lidal/Redtooth/batteryPackCover/MainBody-Body.3mf

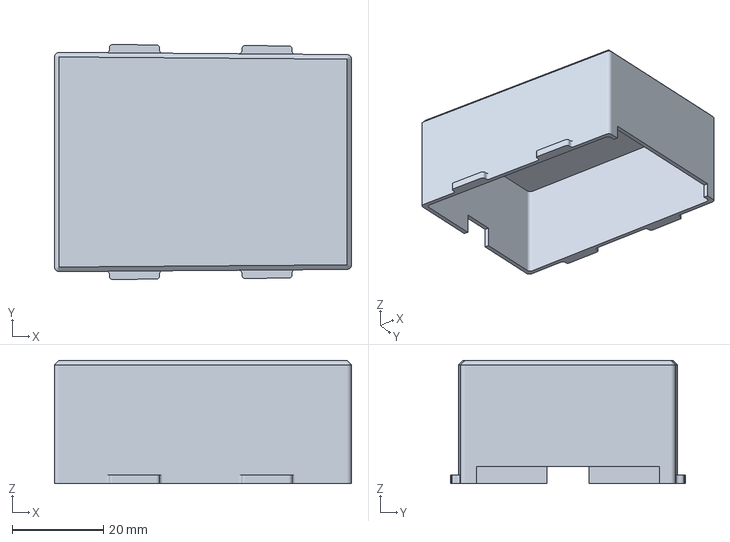
[picture p4: CAD file, 2026-10-31]
batteryPackCover/MainBody-Body.3mf
65.0 x 51.4 x 27.0 mm
