lidal/Redtooth/(list of files, cad)

Other CAD files:
batteryPackCover/MainBody.FCStd
