lidal/Redtooth/(commit log)

2026-10-31 Virtual Boy Bluetooth controller: ESP-IDF firmware and battery case
    Firmware for an ESP32-C6 Feather with three modes (Android gamepad, Xbox
    controller for the 8BitDo adapter, Switch 2 Pro Controller), the FreeCAD
    battery case, and photos of the finished controller.
    [MainBody-Body.3mf, MainBody.FCStd, partitions.csv]
2026-10-31 Rename to Redtooth and add a wiring schematic
    The schematic is drawn with schemdraw from docs/wiring.py, using the
    original controller cable's wire colours.
2026-10-31 Draw the wiring on Adafruit's Feather ESP32-C6 drawing
    docs/wiring.py now builds the SVG itself around the breadboard view of
    Adafruit's Fritzing part (CC BY-SA 3.0) and routes each cable colour to
    its header pin. The README explains the red power-switch wire and IO7.
2026-10-31 README: explain that the red wire is cut and wired from the switch
2026-10-31 Move the battery case files from batteryPack/custom to batteryPack
    [MainBody-Body.3mf, MainBody.FCStd]
2026-10-31 README: add a section about the battery pack cover
2026-10-31 README: make the cover section "Mounting and battery pack cover"
