lidal/Redtooth/IMG_0148.jpeg

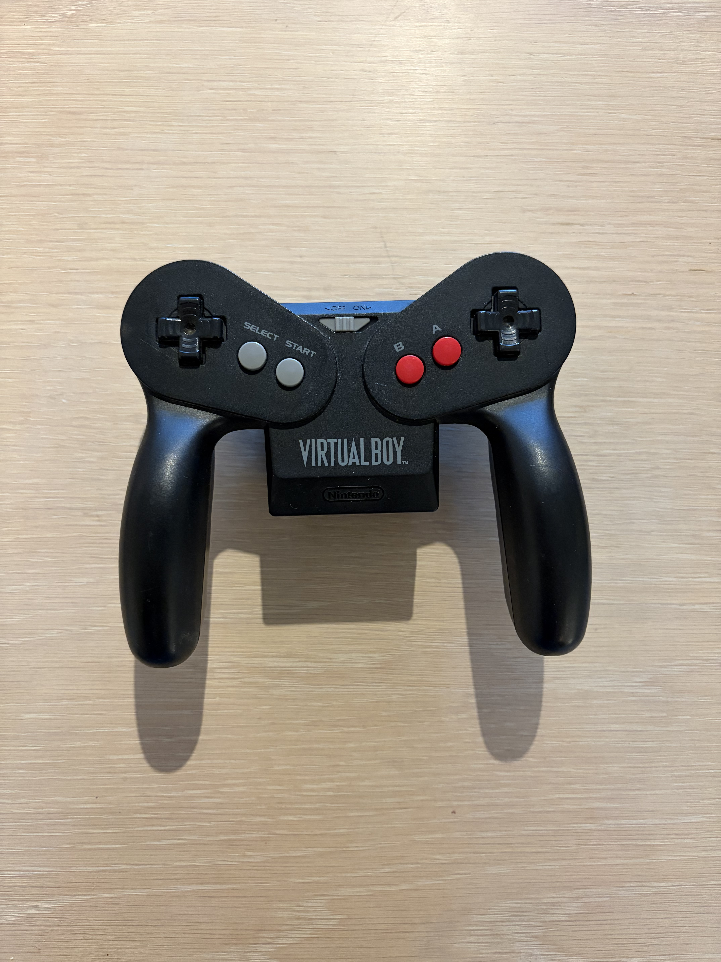
[picture p1: IMG_0148.jpeg]
IMG_0148.jpeg
