lidal/Redtooth/IMG_0149.jpeg

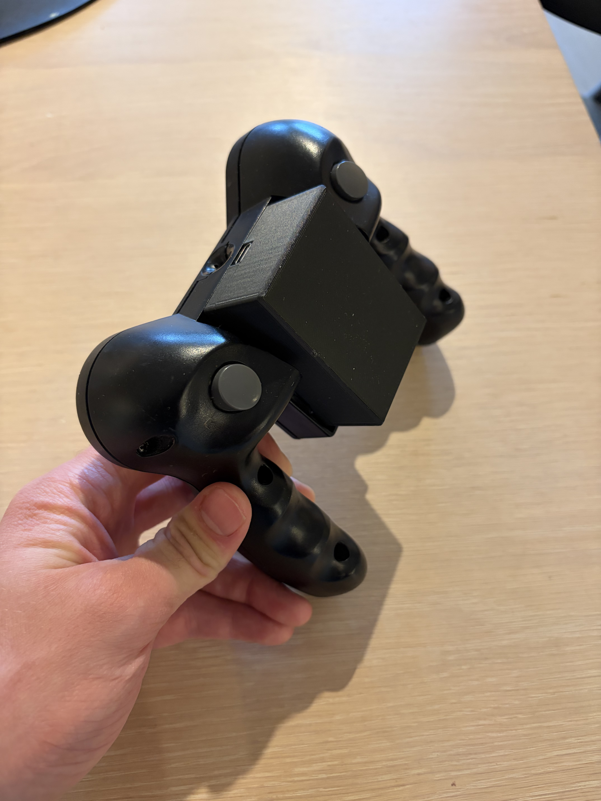
[picture p2: IMG_0149.jpeg]
IMG_0149.jpeg
