lidal/Redtooth/IMG_0150.jpeg

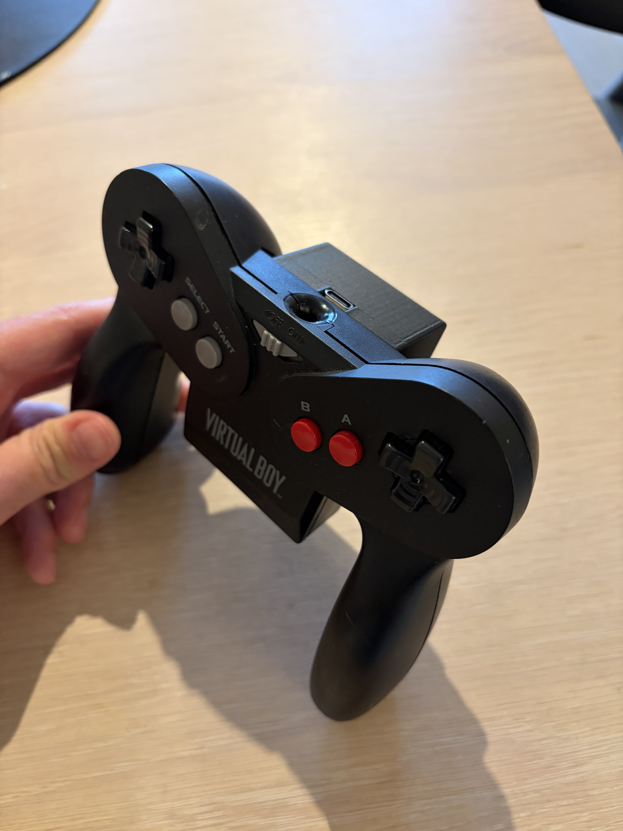
[picture p3: IMG_0150.jpeg]
IMG_0150.jpeg
